kkimm1112/web-bottles-redeem/file_ArduinoCode/ESP32-CAM_classify-bottlles.ino

#include <a456AI_bottles_inferencing.h>

#include "edge-impulse-sdk/dsp/image/image.hpp"

#include "esp_camera.h"
#include <ESP32Servo.h>

#include <HardwareSerial.h>

HardwareSerial mySerial(2);  // ใช้ Serial2 (UART2)

#define SERVO_PIN 13

Servo myServo;

// กำหนดค่ามุมเซอร์โว
#define SERVO_ANGLE_DEFAULT 80
#define SERVO_ANGLE_PET 150
#define SERVO_ANGLE_RESET 0
#define SERVO_DELAY 5000


#define PWDN_GPIO_NUM 32
#define RESET_GPIO_NUM -1
#define XCLK_GPIO_NUM 0
#define SIOD_GPIO_NUM 26
#define SIOC_GPIO_NUM 27

#define Y9_GPIO_NUM 35
#define Y8_GPIO_NUM 34
#define Y7_GPIO_NUM 39
#define Y6_GPIO_NUM 36
#define Y5_GPIO_NUM 21
#define Y4_GPIO_NUM 19
#define Y3_GPIO_NUM 18
#define Y2_GPIO_NUM 5
#define VSYNC_GPIO_NUM 25
#define HREF_GPIO_NUM 23
#define PCLK_GPIO_NUM 22

/* Constant defines -------------------------------------------------------- */
#define EI_CAMERA_RAW_FRAME_BUFFER_COLS 320
#define EI_CAMERA_RAW_FRAME_BUFFER_ROWS 240
#define EI_CAMERA_FRAME_BYTE_SIZE 3

bool petDetected = false;
bool detected;
// **คิวสำหรับสื่อสารระหว่าง Task**
QueueHandle_t irQueue;
QueueHandle_t imageQueue;


/* Private variables ------------------------------------------------------- */
static bool debug_nn = false;  // Set this to true to see e.g. features generated from the raw signal
static bool is_initialised = false;
uint8_t *snapshot_buf;  //points to the output of the capture

static camera_config_t camera_config = {
  .pin_pwdn = PWDN_GPIO_NUM,
  .pin_reset = RESET_GPIO_NUM,
  .pin_xclk = XCLK_GPIO_NUM,
  .pin_sscb_sda = SIOD_GPIO_NUM,
  .pin_sscb_scl = SIOC_GPIO_NUM,

  .pin_d7 = Y9_GPIO_NUM,
  .pin_d6 = Y8_GPIO_NUM,
  .pin_d5 = Y7_GPIO_NUM,
  .pin_d4 = Y6_GPIO_NUM,
  .pin_d3 = Y5_GPIO_NUM,
  .pin_d2 = Y4_GPIO_NUM,
  .pin_d1 = Y3_GPIO_NUM,
  .pin_d0 = Y2_GPIO_NUM,
  .pin_vsync = VSYNC_GPIO_NUM,
  .pin_href = HREF_GPIO_NUM,
  .pin_pclk = PCLK_GPIO_NUM,

  //XCLK 20MHz or 10MHz for OV2640 double FPS (Experimental)
  .xclk_freq_hz = 20000000,
  .ledc_timer = LEDC_TIMER_0,
  .ledc_channel = LEDC_CHANNEL_0,

  .pixel_format = PIXFORMAT_JPEG,  //YUV422,GRAYSCALE,RGB565,JPEG
  .frame_size = FRAMESIZE_QVGA,    //QQVGA-UXGA Do not use sizes above QVGA when not JPEG

  .jpeg_quality = 12,  //0-63 lower number means higher quality
  .fb_count = 1,       //if more than one, i2s runs in continuous mode. Use only with JPEG
  .fb_location = CAMERA_FB_IN_PSRAM,
  .grab_mode = CAMERA_GRAB_WHEN_EMPTY,
};



/* Function definitions ------------------------------------------------------- */
bool ei_camera_init(void);
void ei_camera_deinit(void);
bool ei_camera_capture(uint32_t img_width, uint32_t img_height, uint8_t *out_buf);

// **ฟังก์ชันสำหรับการประมวลผลภาพ**
void imageProcessingTask(void *pvParameters) {
  bool objectDetected;

  while (1) {

    if (xQueueReceive(irQueue, &objectDetected, portMAX_DELAY) == pdPASS) {

      // instead of wait_ms, we'll wait on the signal, this allows threads to cancel us...
      if (ei_sleep(5) != EI_IMPULSE_OK) {
        free(snapshot_buf);  // คืนหน่วยความจำก่อนออกจากฟังก์ชัน
        return;
      }

      snapshot_buf = (uint8_t *)ps_malloc(EI_CAMERA_RAW_FRAME_BUFFER_COLS * EI_CAMERA_RAW_FRAME_BUFFER_ROWS * EI_CAMERA_FRAME_BYTE_SIZE);

      // check if allocation was successful
      if (snapshot_buf == nullptr) {
        ei_printf("ERR: Failed to allocate snapshot buffer!\n");
        return;
      }


      ei::signal_t signal;
      signal.total_length = EI_CLASSIFIER_INPUT_WIDTH * EI_CLASSIFIER_INPUT_HEIGHT;
      signal.get_data = &ei_camera_get_data;

      if (ei_camera_capture((size_t)EI_CLASSIFIER_INPUT_WIDTH, (size_t)EI_CLASSIFIER_INPUT_HEIGHT, snapshot_buf) == false) {
        ei_printf("Failed to capture image\r\n");
        free(snapshot_buf);
        return;
      }

      // Run the classifier
      ei_impulse_result_t result = { 0 };

      EI_IMPULSE_ERROR err = run_classifier(&signal, &result, debug_nn);
      if (err != EI_IMPULSE_OK) {
        ei_printf("ERR: Failed to run classifier (%d)\n", err);
        free(snapshot_buf);
        continue;
      }

      // print the predictions
      ei_printf("Predictions (DSP: %d ms., Classification: %d ms., Anomaly: %d ms.): \n",
                result.timing.dsp, result.timing.classification, result.timing.anomaly);

#if EI_CLASSIFIER_OBJECT_DETECTION == 1
      ei_printf("Object detection bounding boxes:\r\n");
      bool detected = false;  // ตัวแปรเพื่อตรวจสอบว่าพบขวด PET หรือไม่
      bool already_sent = false;     // ตรวจว่าส่ง Serial2 ไปหรือยัง

      for (uint32_t i = 0; i < result.bounding_boxes_count; i++) {
        ei_impulse_result_bounding_box_t bb = result.bounding_boxes[i];
        if (bb.value == 0) {
          continue;
        }

        ei_printf("  %s (%f) [ x: %u, y: %u, width: %u, height: %u ]\r\n",
                  bb.label,
                  bb.value,
                  bb.x,
                  bb.y,
                  bb.width,
                  bb.height);

        if (!already_sent && (strcmp(bb.label, "PETbig") == 0 || strcmp(bb.label, "PETsmall") == 0)) {
          detected = true;
          // ส่งข้อมูลผ่าน Serial2
          mySerial.println(bb.label);
          already_sent = true;
        }
        // ส่งผลการตรวจจับไปยัง Queue
      }



      // Print the prediction results (classification)
#else
      ei_printf("Predictions:\r\n");
      for (uint16_t i = 0; i < EI_CLASSIFIER_LABEL_COUNT; i++) {
        ei_printf("  %s: ", ei_classifier_inferencing_categories[i]);
        ei_printf("%.5f\r\n", result.classification[i].value);
      }
#endif

      // Print anomaly result (if it exists)
#if EI_CLASSIFIER_HAS_ANOMALY
      ei_printf("Anomaly prediction: %.3f\r\n", result.anomaly);
#endif

      xQueueSend(imageQueue, &detected, portMAX_DELAY);

      free(snapshot_buf);
    }

    vTaskDelay(200 / portTICK_PERIOD_MS);
  }
}


// **ฟังก์ชันสำหรับการควบคุมการทำงานด้วย Serial2 และ Servo**
void serialAndServoTask(void *pvParameters) {
  myServo.attach(SERVO_PIN);
  myServo.write(80);  // ตั้งต้นที่ 90 องศา (เตรียมพร้อม)


  TickType_t detectionStartTime = 0;                      // เวลาที่เริ่มตรวจจับ
  const TickType_t TIMEOUT = 5000 / portTICK_PERIOD_MS;  // ระยะเวลา 15 วินาที
  String receivedData = "";                               // ตัวแปรเก็บข้อความจาก Serial2

  while (1) {
    receivedData = "";  // รีเซ็ตค่า
    while (mySerial.available()) {
      char c = mySerial.read();
      receivedData += c;
      vTaskDelay(10 / portTICK_PERIOD_MS);  // หน่วงเวลาอ่านข้อมูล
    }

    receivedData.trim();  // ตัดช่องว่างหรืออักขระขึ้นบรรทัดใหม่

    if (receivedData == "Start") {
      Serial.println("Received 'Start' command.");

      // ส่งสัญญาณให้ imageProcessingTask เริ่มทำงาน
      bool objectDetected = true;
      xQueueSend(irQueue, &objectDetected, portMAX_DELAY);

      detectionStartTime = xTaskGetTickCount();  // บันทึกเวลาที่เริ่มตรวจจับ
      detected = false;                          // รีเซ็ตสถานะตรวจจับก่อนรอผล

      while ((xTaskGetTickCount() - detectionStartTime) < TIMEOUT) {
        if (xQueueReceive(imageQueue, &detected, 500 / portTICK_PERIOD_MS) == pdPASS) {
          if (detected) {
            Serial.println("PET Bottle Detected. Moving Servo to 0°...");
            myServo.write(0);
            mySerial.println("correct");
            vTaskDelay(SERVO_DELAY / portTICK_PERIOD_MS);
            myServo.write(80);
            Serial.println("Servo returned to 80° (Ready Position)");
            break;  // พบข้อมูลถูกต้อง ออกจากลูป
          }
        }
      }

      // ถ้าหมดเวลารอแล้วยังไม่มีข้อมูลถูกต้อง
      if (!detected) {
        Serial.println("Incorrect Object Detected for too long. Moving Servo to 150°...");
        myServo.write(150);
        mySerial.println("incorrect");

        // รอจนกว่าจะได้รับ "Try again" จาก Serial2
        while (true) {
          receivedData = "";  // รีเซ็ตค่า
          while (mySerial.available()) {
            char c = mySerial.read();
            receivedData += c;
            vTaskDelay(10 / portTICK_PERIOD_MS);
          }

          receivedData.trim();  // ตัดช่องว่างหรืออักขระขึ้นบรรทัดใหม่

          if (receivedData == "Try again") {
            Serial.println("Received 'Try again' command. Returning Servo to 80°...");
            myServo.write(75);
            myServo.write(80);
            break;  // ออกจากลูป รอคำสั่งใหม่
          }

          vTaskDelay(100 / portTICK_PERIOD_MS);  // ป้องกันการทำงานหนักเกินไป
        }
      }
    }

    vTaskDelay(100 / portTICK_PERIOD_MS);
  }
}

// เพิ่ม Task นี้เข้าไปใน setup()
void keepAliveTask(void *pvParameters) {
  while (1) {
    mySerial.println("connect");      // ส่ง "connect" ไปยังอีกบอร์ด
    vTaskDelay(pdMS_TO_TICKS(5000));  // หน่วงเวลา 5 วินาที
  }
}

// **ฟังก์ชัน setup()**
void setup() {
  Serial.begin(115200);
  mySerial.begin(115200, SERIAL_8N1, 12, 15);

  if (psramFound()) {
    Serial.println("PSRAM OK!");
  } else {
    Serial.println("PSRAM NOT FOUND!");
  }

  if (!ei_camera_init()) {
    Serial.println("Failed to initialize Camera!");
    return;
  }

  // สร้าง Task สำหรับส่ง "connect" เป็นระยะ
  xTaskCreatePinnedToCore(keepAliveTask, "KeepAlive", 2048, NULL, 1, NULL, 0);

  irQueue = xQueueCreate(5, sizeof(bool));
  imageQueue = xQueueCreate(10, sizeof(bool));

  xTaskCreatePinnedToCore(imageProcessingTask, "ImageProcessing", 8192, NULL, 1, NULL, 1);
  xTaskCreatePinnedToCore(serialAndServoTask, "SensorAndServo", 2048, NULL, 1, NULL, 0);
}

// **ฟังก์ชัน loop()**
void loop() {
  vTaskDelay(portMAX_DELAY);
}

bool ei_camera_init(void) {
  if (is_initialised) return true;

  //initialize the camera
  esp_err_t err = esp_camera_init(&camera_config);
  if (err != ESP_OK) {
    Serial.printf("Camera init failed with error 0x%x\n", err);
    return false;
  }

  sensor_t *s = esp_camera_sensor_get();
  // initial sensors are flipped vertically and colors are a bit saturated
  if (s->id.PID == OV2640_PID) {
    s->set_vflip(s, 1);       // flip it back
    s->set_brightness(s, 1);  // up the brightness just a bit
    s->set_saturation(s, 0);  // lower the saturation
  }

#if defined(CAMERA_MODEL_M5STACK_WIDE)
  s->set_vflip(s, 1);
  s->set_hmirror(s, 1);
#endif

  is_initialised = true;
  return true;
}


void ei_camera_deinit(void) {
  //deinitialize the camera
  esp_err_t err = esp_camera_deinit();

  if (err != ESP_OK) {
    ei_printf("Camera deinit failed\n");
    return;
  }

  is_initialised = false;
  return;
}


bool ei_camera_capture(uint32_t img_width, uint32_t img_height, uint8_t *out_buf) {
  bool do_resize = false;

  if (!is_initialised) {
    ei_printf("ERR: Camera is not initialized\r\n");
    return false;
  }

  camera_fb_t *fb = esp_camera_fb_get();

  if (!fb) {
    ei_printf("Camera capture failed\n");
    return false;
  }

  bool converted = fmt2rgb888(fb->buf, fb->len, PIXFORMAT_JPEG, snapshot_buf);

  esp_camera_fb_return(fb);

  if (!converted) {
    ei_printf("Conversion failed\n");
    return false;
  }

  if ((img_width != EI_CAMERA_RAW_FRAME_BUFFER_COLS)
      || (img_height != EI_CAMERA_RAW_FRAME_BUFFER_ROWS)) {
    do_resize = true;
  }

  if (do_resize) {
    ei::image::processing::crop_and_interpolate_rgb888(
      out_buf,
      EI_CAMERA_RAW_FRAME_BUFFER_COLS,
      EI_CAMERA_RAW_FRAME_BUFFER_ROWS,
      out_buf,
      img_width,
      img_height);
  }

  return true;
}

static int ei_camera_get_data(size_t offset, size_t length, float *out_ptr) {
  // we already have a RGB888 buffer, so recalculate offset into pixel index
  size_t pixel_ix = offset * 3;
  size_t pixels_left = length;
  size_t out_ptr_ix = 0;

  while (pixels_left != 0) {
    // Swap BGR to RGB here
    // due to https://github.com/espressif/esp32-camera/issues/379
    out_ptr[out_ptr_ix] = (snapshot_buf[pixel_ix + 2] << 16) + (snapshot_buf[pixel_ix + 1] << 8) + snapshot_buf[pixel_ix];

    // go to the next pixel
    out_ptr_ix++;
    pixel_ix += 3;
    pixels_left--;
  }
  // and done!
  return 0;
}

#if !defined(EI_CLASSIFIER_SENSOR) || EI_CLASSIFIER_SENSOR != EI_CLASSIFIER_SENSOR_CAMERA
#error "Invalid model for current sensor"
#endif
